kekoraa/usb-c-pd-bench-breakout/docs/images/block-diagram.png

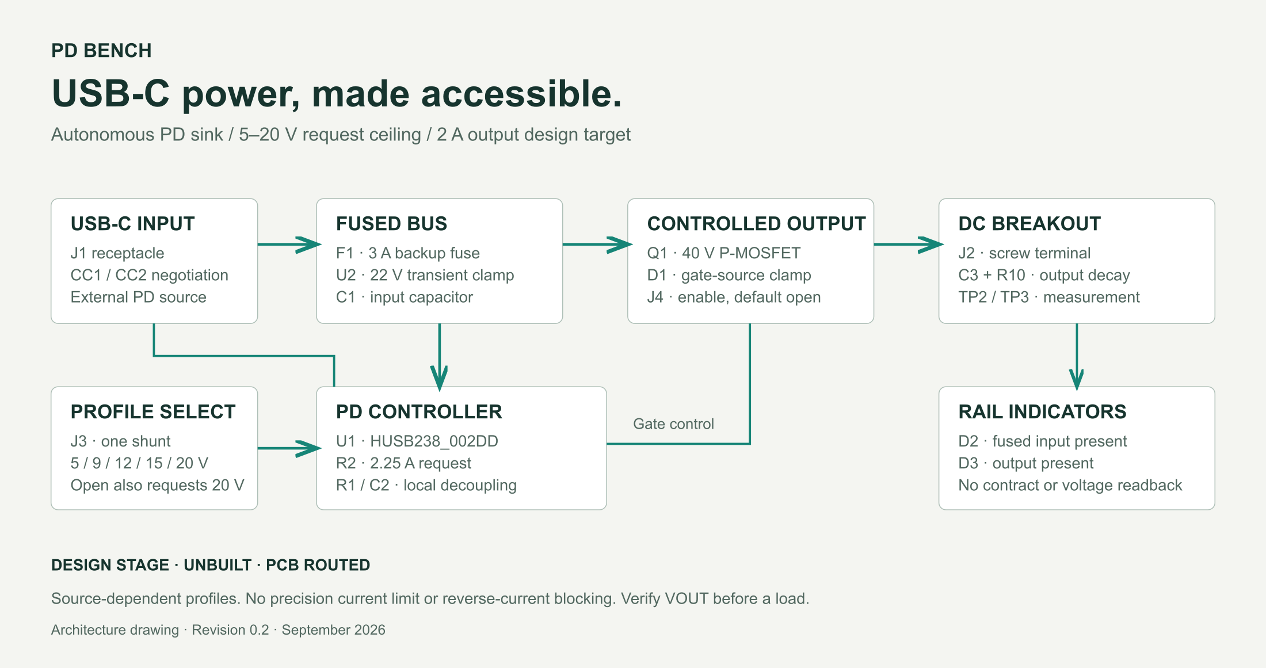
docs/images/block-diagram.png
