kekoraa/usb-c-pd-bench-breakout/docs/images/pcb-bare-board.png

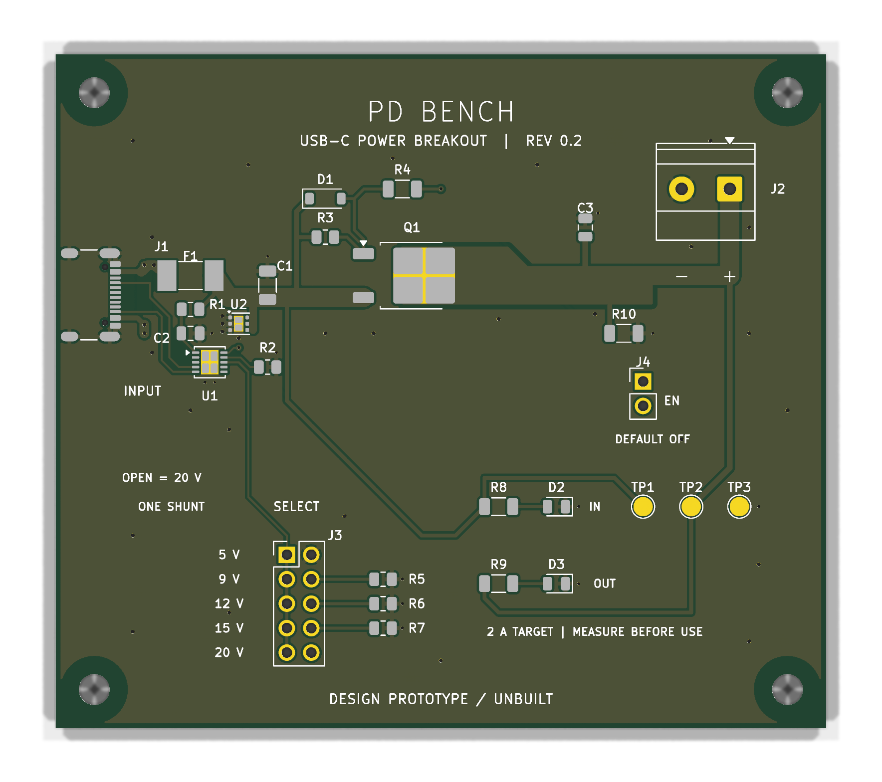
docs/images/pcb-bare-board.png
