kekoraa/usb-c-pd-bench-breakout/docs/images/pcb-routed-back.png

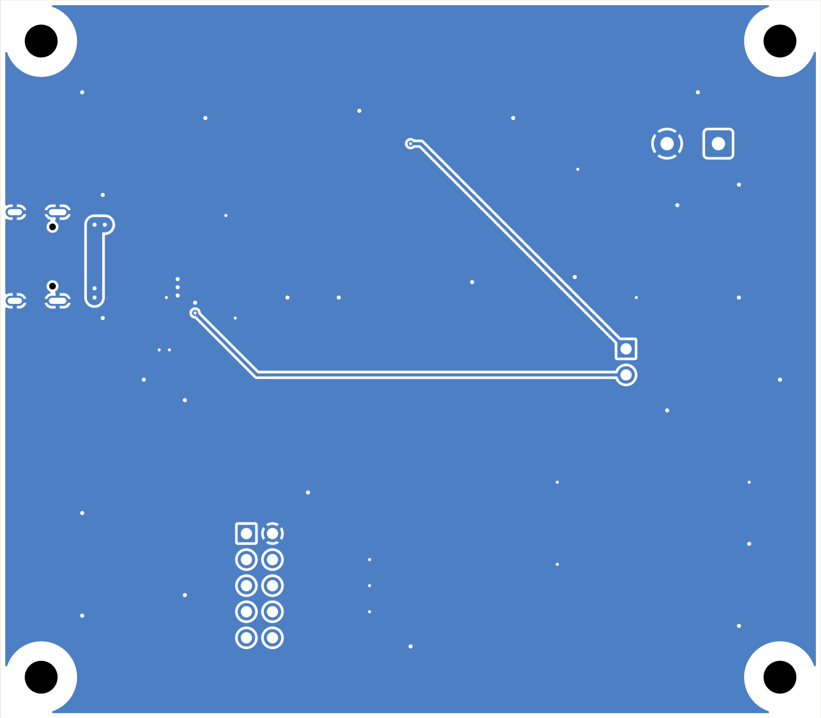
docs/images/pcb-routed-back.png
