kekoraa/usb-c-pd-bench-breakout/docs/images/pcb-routed-front.png

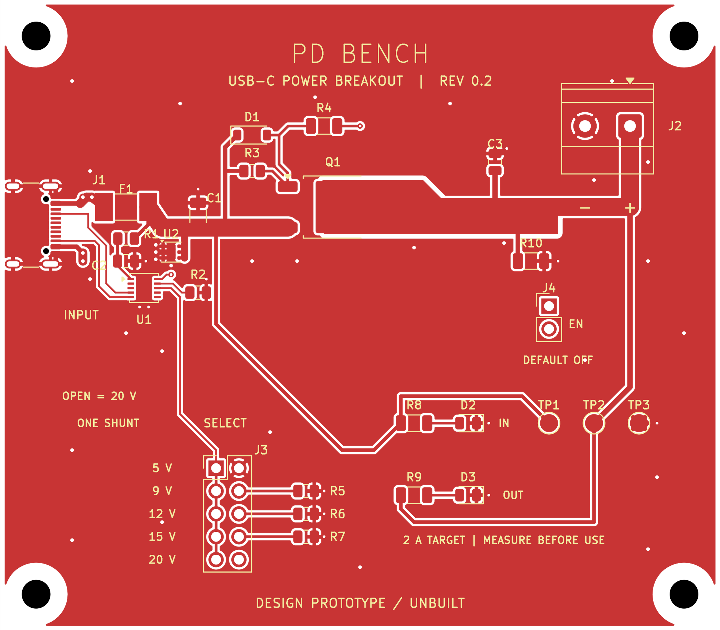
docs/images/pcb-routed-front.png
