kekoraa/usb-c-pd-bench-breakout/docs/images/pd-bench.png

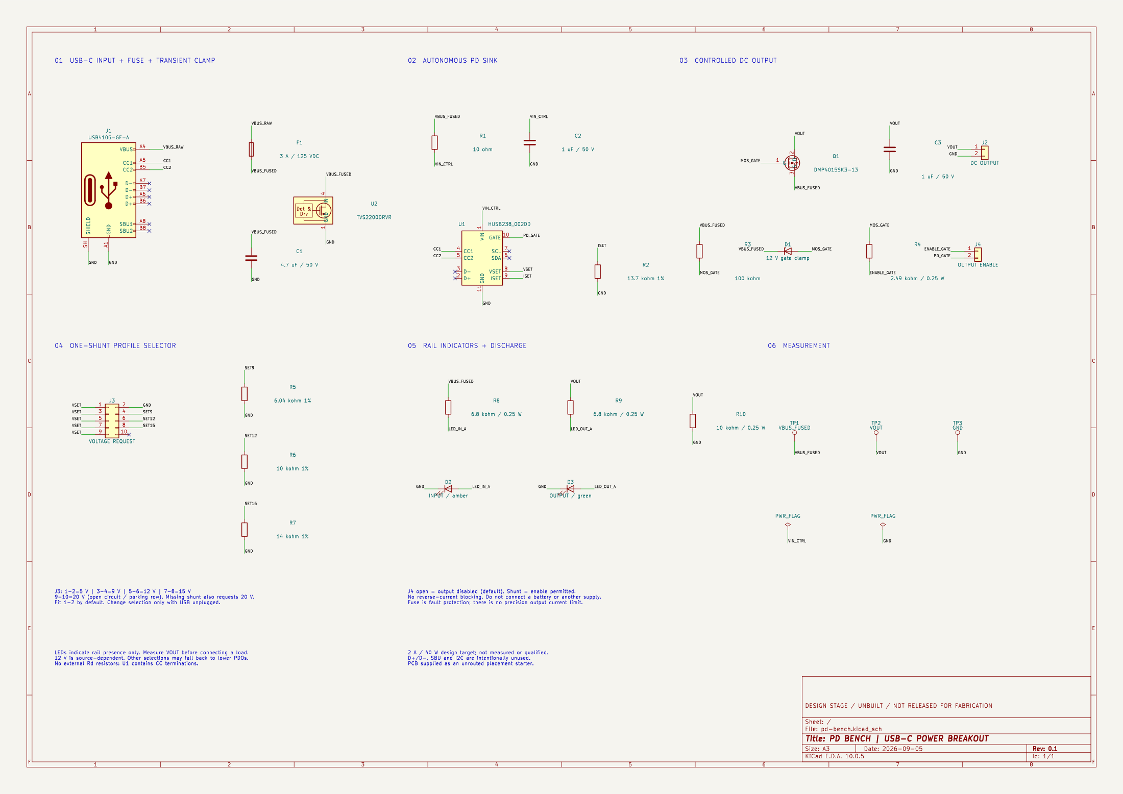
docs/images/pd-bench.png
