kekoraa/usb-c-pd-bench-breakout/hardware/pd-bench.kicad_pcb

## KiCad design hardware/pd-bench.kicad_pcb (2026-09-08)

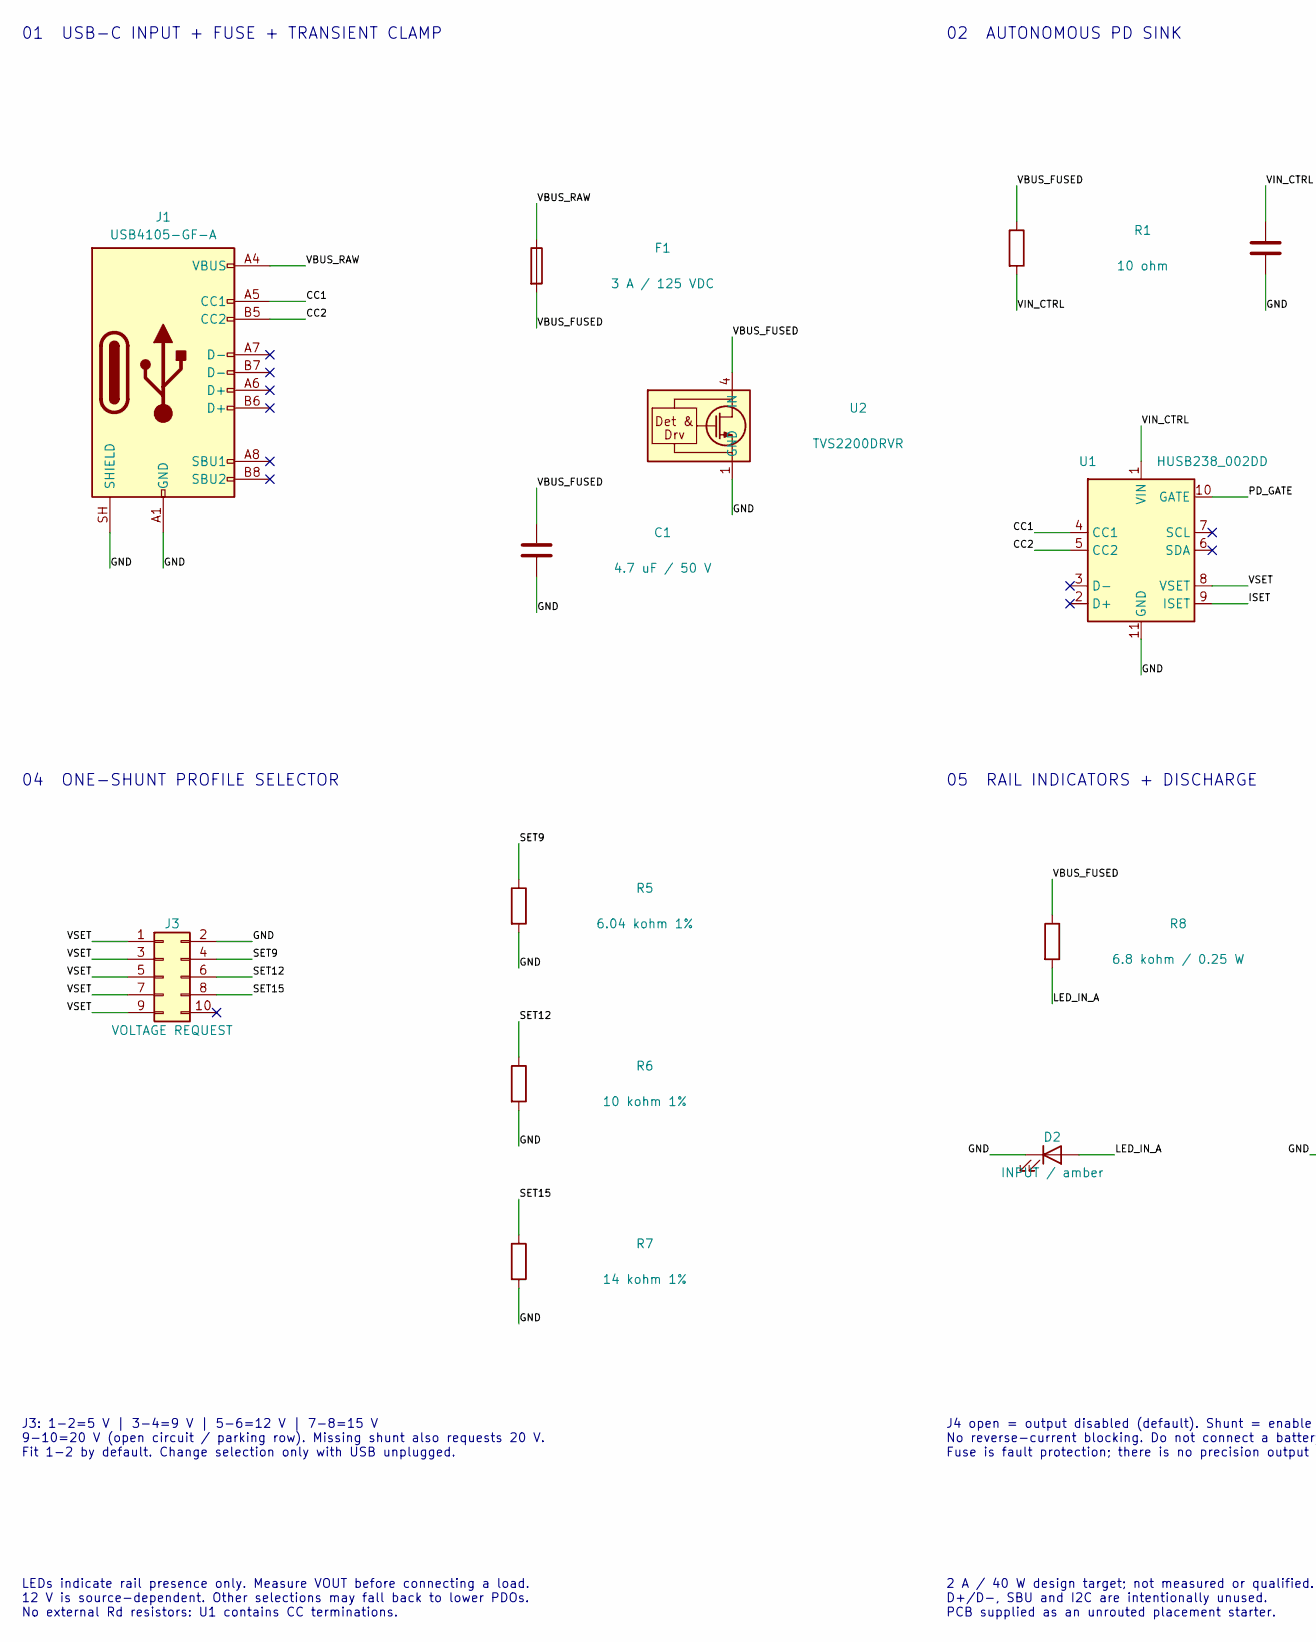
[picture p6: schematic pd-bench.kicad_sch, PD BENCH | USB-C POWER BREAKOUT, part in row 1, column 1]

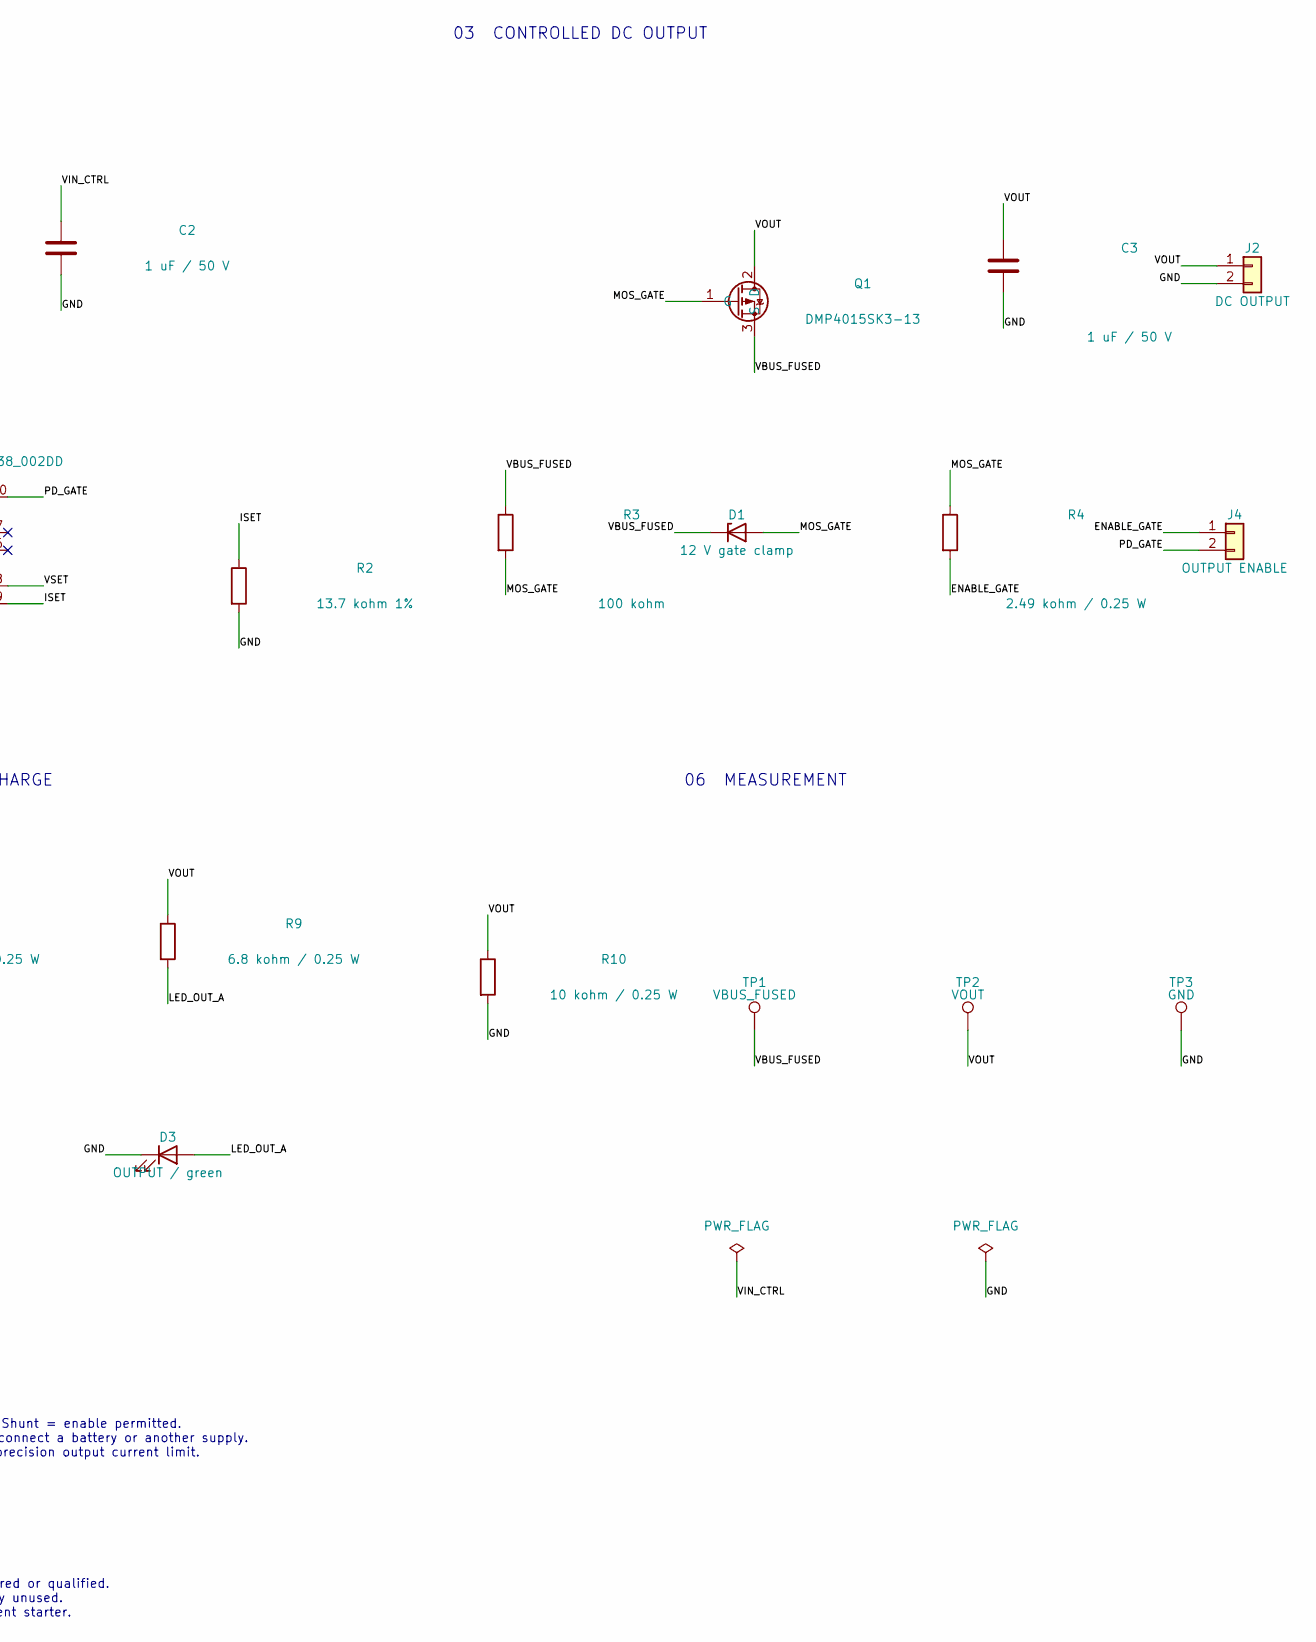
[picture p7: schematic pd-bench.kicad_sch, PD BENCH | USB-C POWER BREAKOUT, part in row 1, column 2]

Parts:
C1: 4.7 uF / 50 V; C_1206_3216Metric; MPN GRM31CR71H475KA12L
C2, C3: 1 uF / 50 V; C_0805_2012Metric; MPN C2012X7R1H105K125AB
D1: 12 V gate clamp; D_SOD-123; MPN BZT52-C12X
D2: INPUT / amber; LED_0805_2012Metric; MPN LTST-C170KSKT
D3: OUTPUT / green; LED_0805_2012Metric; MPN LTST-C170KGKT
F1: 3 A / 125 VDC; Fuse_Littelfuse-NANO2-451_453; MPN 0451003.MRL
J1: USB4105-GF-A; USB_C_Receptacle_GCT_USB4105-xx-A_16P_TopMnt_Horizontal; MPN USB4105-GF-A
J2: DC OUTPUT; TerminalBlock_Phoenix_MKDS-1,5-2_1x02_P5.00mm_Horizontal; MPN 1715022
J3: VOLTAGE REQUEST; PinHeader_2x05_P2.54mm_Vertical; MPN 61301021121
J4: OUTPUT ENABLE; PinHeader_1x02_P2.54mm_Vertical; MPN 61300211121
Q1: DMP4015SK3-13; TO-252-2; MPN DMP4015SK3-13
R1: 10 ohm; R_0805_2012Metric; MPN RC0805FR-0710RL
R2: 13.7 kohm 1%; R_0805_2012Metric; MPN RC0805FR-0713K7L
R3: 100 kohm; R_0805_2012Metric; MPN RC0805FR-07100KL
R4: 2.49 kohm / 0.25 W; R_1206_3216Metric; MPN RC1206FR-072K49L
R5: 6.04 kohm 1%; R_0805_2012Metric; MPN RC0805FR-076K04L
R6: 10 kohm 1%; R_0805_2012Metric; MPN RC0805FR-0710KL
R7: 14 kohm 1%; R_0805_2012Metric; MPN RC0805FR-0714KL
R8, R9: 6.8 kohm / 0.25 W; R_1206_3216Metric; MPN RC1206FR-076K8L
R10: 10 kohm / 0.25 W; R_1206_3216Metric; MPN RC1206FR-0710KL
TP1: VBUS_FUSED; TestPoint_Pad_D2.0mm; MPN PCB pad
TP2: VOUT; TestPoint_Pad_D2.0mm; MPN PCB pad
TP3: GND; TestPoint_Pad_D2.0mm; MPN PCB pad
U1: HUSB238_002DD; WDFN-10-1EP_3x3mm_P0.5mm_EP1.8x2.5mm; MPN HUSB238_002DD
U2: TVS2200DRVR; WSON-6-1EP_2x2mm_P0.65mm_EP1x1.6mm; MPN TVS2200DRVR

Connections:
/CC1: J1.A5 (CC1), U1.4 (CC1)
/CC2: J1.B5 (CC2), U1.5 (CC2)
/ENABLE_GATE: J4.1, R4.2
/GND: C1.2, C2.2, C3.2, D2.1 (K), D3.1 (K), J1.A1 (GND), J1.A12 (GND), J1.B1 (GND), J1.B12 (GND), J1.SH (SHIELD), J2.2, J3.2, R2.2, R5.2, R6.2, R7.2, R10.2, TP3.1, U1.11 (GND), U2.1 (GND), U2.2 (GND), U2.3 (GND), U2.7 (GND)
/ISET: R2.1, U1.9 (ISET)
/LED_IN_A: D2.2 (A), R8.2
/LED_OUT_A: D3.2 (A), R9.2
/MOS_GATE: D1.2 (A), Q1.1 (G), R3.2, R4.1
/PD_GATE: J4.2, U1.10 (GATE)
/SET9: J3.4, R5.1
/SET12: J3.6, R6.1
/SET15: J3.8, R7.1
/VBUS_FUSED: C1.1, D1.1 (K), F1.2, Q1.3 (S), R1.1, R3.1, R8.1, TP1.1, U2.4 (IN), U2.5 (IN), U2.6 (IN)
/VBUS_RAW: F1.1, J1.A4 (VBUS), J1.A9 (VBUS), J1.B4 (VBUS), J1.B9 (VBUS)
/VIN_CTRL: C2.1, R1.2, U1.1 (VIN)
/VOUT: C3.1, J2.1, Q1.2 (D), R9.1, R10.1, TP2.1
/VSET: J3.1, J3.3, J3.5, J3.7, J3.9, U1.8 (VSET)

Notes on the sheet:
01 USB-C INPUT + FUSE + TRANSIENT CLAMP
02 AUTONOMOUS PD SINK
03 CONTROLLED DC OUTPUT
04 ONE-SHUNT PROFILE SELECTOR
05 RAIL INDICATORS + DISCHARGE
06 MEASUREMENT
J3: 1-2=5 V | 3-4=9 V | 5-6=12 V | 7-8=15 V 9-10=20 V (open circuit / parking row). Missing shunt also requests 20 V. Fit 1-2 by default. Change selection only with USB unplugged.
J4 open = output disabled (default). Shunt = enable permitted. No reverse-current blocking. Do not connect a battery or another supply. Fuse is fault protection; there is no precision output current limit.
LEDs indicate rail presence only. Measure VOUT before connecting a load. 12 V is source-dependent. Other selections may fall back to lower PDOs. No external Rd resistors: U1 contains CC terminations.
2 A / 40 W design target; not measured or qualified. D+/D-, SBU and I2C are intentionally unused. PCB supplied as an unrouted placement starter.

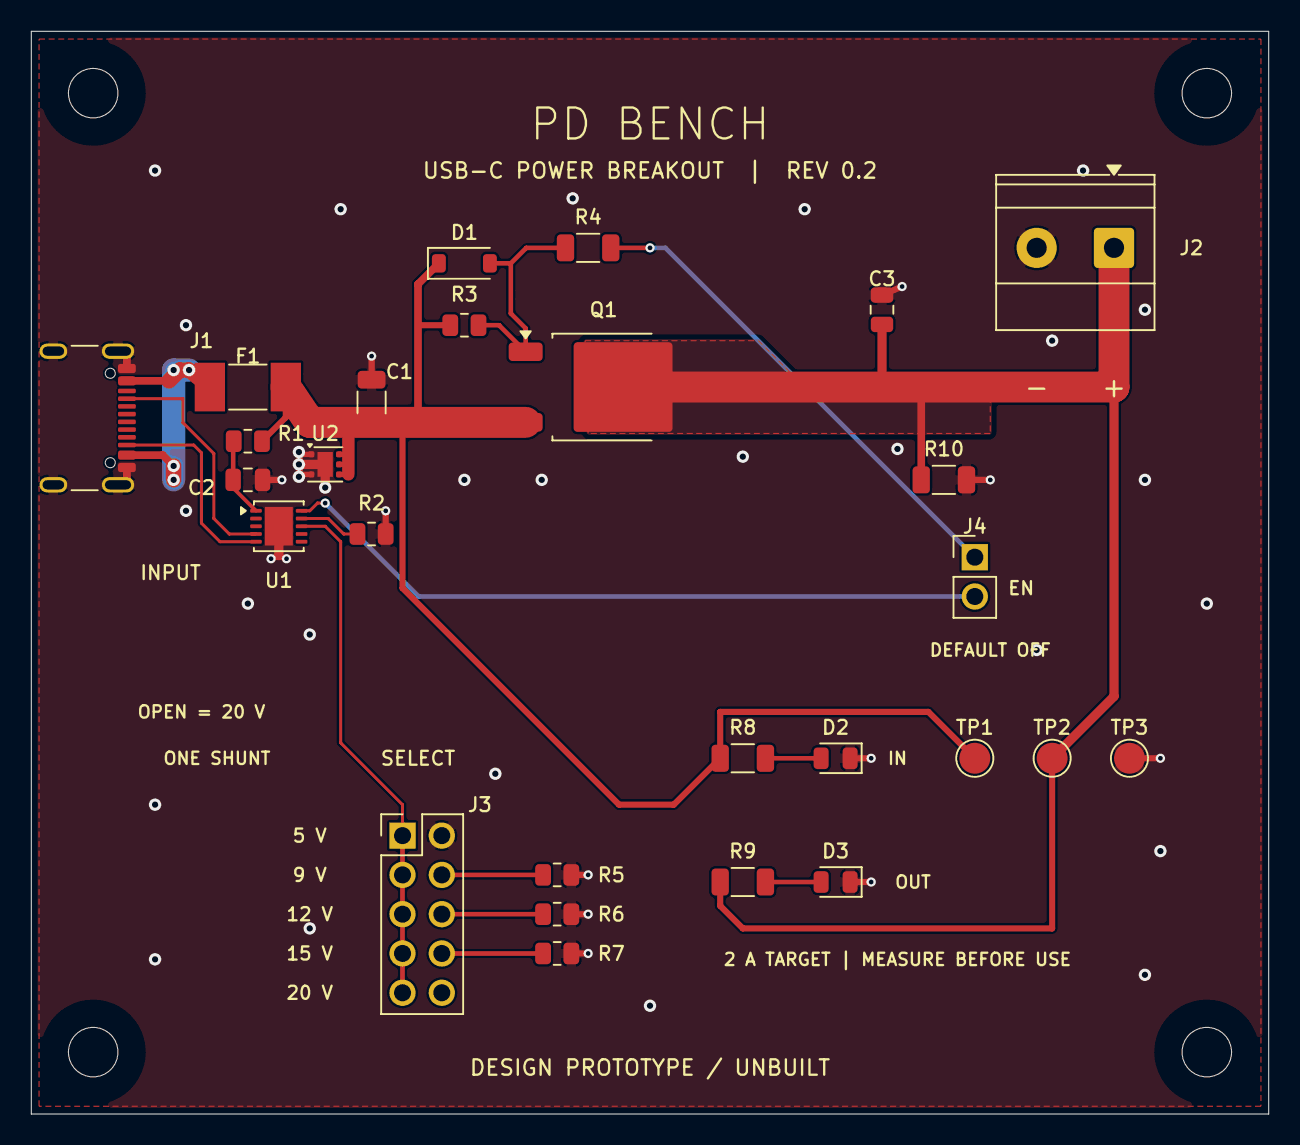
[picture p8: board pd-bench.kicad_pcb from above]

Board: 2 copper layers, 80.0 x 70.0 mm, 31 parts (0 on the bottom side), 17 nets.

Other parts of the board:
H1, H2, H3, H4: M3; MountingHole_3.2mm_M3
